flatos/Honda-HRX217-Deck-Repair/models/Reinforcing Ring Final.STL

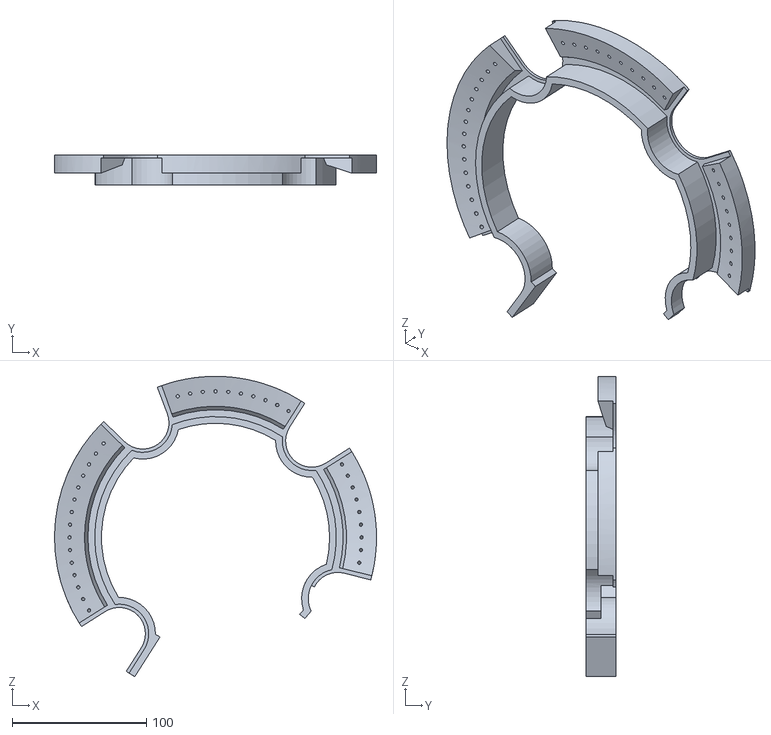
[picture p10: CAD file, 2024-09-07]
models/Reinforcing Ring Final.STL
240.0 x 22.0 x 223.8
