flatos/Honda-HRX217-Deck-Repair/models/Fit Test Final.STL

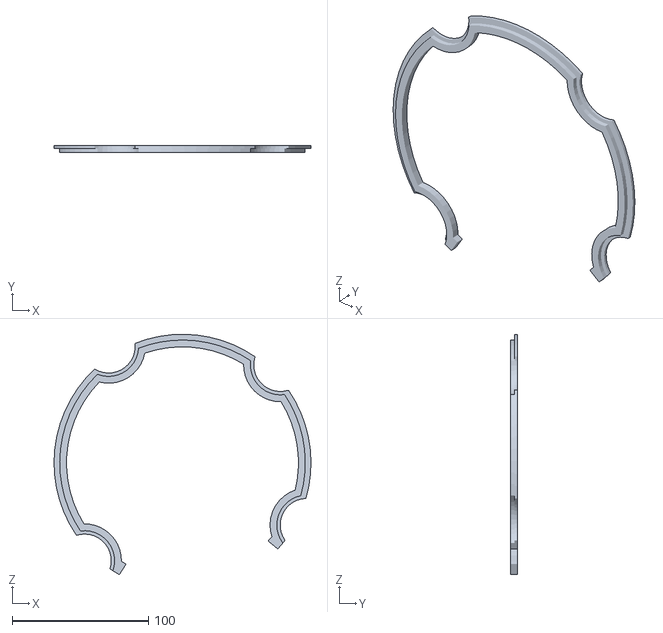
[picture p11: CAD file, 2024-09-07]
models/Fit Test Final.STL
188.4 x 4.95 x 176.3
